ShubhamChouksey123/Terrace-Farming-Robot/README.md

# Terrace-Farming-Robot
Terrace Farming Robot capable of ascending and descending terrace farm and can also perform farming operations like ploughing and seeding.
We have build various easilt attachabe and detachable modules to perform various farming operations.
