ShubhamChouksey123/Terrace-Farming-Robot/Capture.PNG

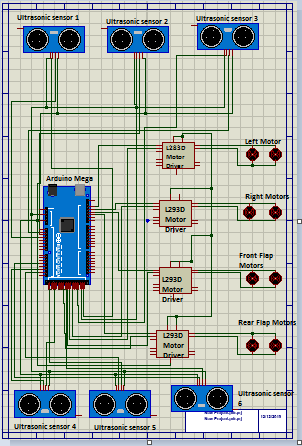
Capture.PNG
